KarpelesLab/ledger_nano_s_re/README.md

# Ledger Nano S — Hardware Reverse Engineering

Notes on the hardware of a Ledger Nano S, starting from photos of the bare
PCB. Raw photos are in [`pics/`](pics/). Zoomed crops of the key parts are in
[`docs/img/`](docs/img/).

**Interactive 3D board map: https://karpeleslab.github.io/ledger_nano_s_re/**

> **How sure are we?** Each item below is marked as one of:
> **[confirmed]** (read directly off the board), **[likely]** (strong
> evidence but not checked electrically) or **[hypothesis]** (needs probing).

## Photos

| File | Content |
|---|---|
| `20261112_174544.JPG` | Back side, far half (button S1 / U4 end) |
| `20261112_174549.JPG` | Back side, USB half (5-pad header, U1 thermal vias) |
| `20261112_174600.JPG` | Front, USB half (J1, U1, U2, U3, S2) |
| `20261112_174607.JPG` | Front, far half (J2, U4, L1, S1) |
| `20261112_174622.JPG` | Front, far half (sharper) |
| `20261112_174629/34/41.JPG` | Front, USB half (several focus/lighting variants) |
| `20261112_183829/53.JPG` | Front, USB half, **components removed** (U1, U2, U3, J1, S2 off) |
| `20261112_183835/41.JPG` | Front, far half, **components removed** (J2, U4, L1, C1, C7-C9, S1 off) |
| `20261112_183926.JPG` | Removed U2 and U1, markings upright (ST pin-1 dot at bottom-left) |

The back-side photos are mirrored compared to the front: on the back the USB
connector is on the right.

## Board overview

- 2-layer-looking (maybe more) blue soldermask PCB, long thin strip that fits
  in the swivel case. Notches along the top edge line up with the case clips.
- All parts are on the front (top) side. The back has only traces, vias, test
  pads and the through-hole legs/tabs of J1 and the buttons.
- PCB date code on the back silkscreen: **`1751`** (likely 2017, week 51),
  next to the literal text `YWX` (probably the fab's year/week template
  label). This fits the component date codes (weeks 744 and 749 of 2017).
- An orange paint dot on the USB shield looks like a factory QC/inspection
  mark.
- The PCB edges are rough and fibrous all around. This could be from
  depanelization or from removing the board from its case.

## KiCad reconstruction

There is a KiCad 10 project in [`kicad/`](kicad/). It has the board outline,
every part placed from the photos, the photos as aligned underlay layers, and
a schematic with the nets known so far. Details and assumptions are in
[docs/kicad.md](docs/kicad.md).

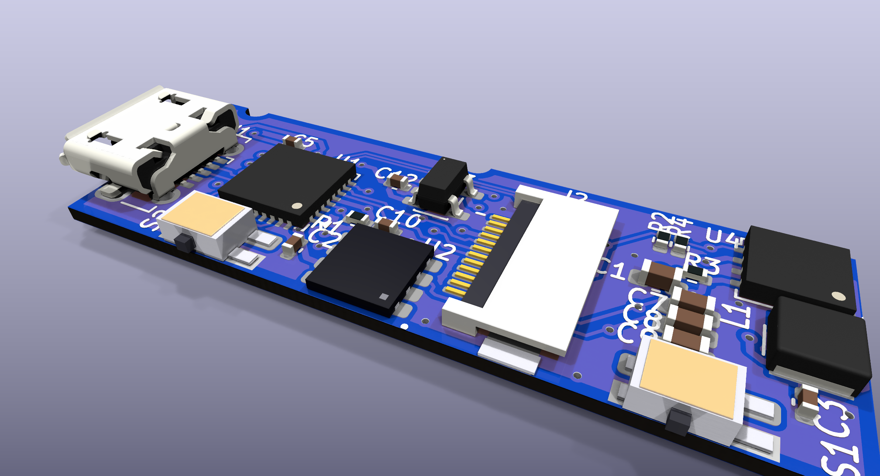
[picture p1: docs/img/render_iso.png]
3D render


**Interactive 3D view:** [online](https://karpeleslab.github.io/ledger_nano_s_re/kicad/viewer3d.html) or [`kicad/viewer3d.html`](kicad/viewer3d.html), published on GitHub Pages by
`.github/workflows/pages.yml` on every push to `master`. To open it locally, serve the `kicad/` folder
over HTTP (e.g. `python3 -m http.server -d kicad`). Hover a part for what it is and the net on
each pin, or a pad, track or via to light up its whole net on both sides. The board photos can be laid
on both faces. Rebuild its data (`kicad/scene.js`, `kicad/photo_*.jpg`) after editing the board with
`python3 tools/export_scene.py`.

## Bill of materials (as seen)

| Ref | Marking | Package | Identification |
|-----|---|---|---|
| **U1** | `F042K6` / `GQ22Z 1193` / `CHN 749 A`, ST logo, e3 | UFQFPN32 (5×5 mm) with exposed pad | **STM32F042K6** Cortex-M0, 32 KB Flash, 6 KB RAM, crystal-less USB FS. This is the main (non-secure) MCU. It handles USB, the display and the buttons. Date code 2017 wk 49. **[confirmed]** |
| **U2** | `NBO` / `PHL744` / `7B`, ST logo | DFN8 + exposed pad, **4.0 x 4.2 mm** (measured). Land pattern: pads 1.2 x 0.75 mm, pitch 0.98 mm, 2.1 x 3.45 mm EP with no vias | ST part, probably the **secure element** (ST31H320 family). ST prints internal codes rather than the part number. It is **not** an MFF2 package (MFF2 is 5x6 mm), so its pinout is ST's own (see below). Date 2017 wk 44. **[likely]** |
| **U3** | `AD30` | SOT-23-5 (3+2 leads), pin 1 dot next to "C12" | **3.0 V LDO**: pins 1 (VIN) and 3 (EN) on VBUS with input cap C12, pin 2 GND, pin 5 (VOUT) on the +3V0 rail (measured **2.997 V**). **[confirmed]** |
| **U4** | `8R00W` / `MYS749`, ST logo, e4 | DFN8 4×4 mm with exposed pad (2×3 thermal vias on the back) | **ST8R00**, a synchronous PWM step-up DC-DC converter. Input 4–6 V, so it must run from USB VBUS rather than the 3.0 V rail. Output is set to 6–12 V by a resistor divider. Switches at 1.7 MHz, up to 1 A. Its external parts are L1, C7–C9 and the R2/R4 divider. The 6–12 V output fits an SSD1306-class OLED panel VCC (7–15 V), so it **almost certainly powers the display**. Date 2017 wk 49. **[likely — marking + datasheet]** |
| **L1** | `100` | ~3×3 mm shielded power inductor | 10 µH. It is the inductor for the ST8R00 boost converter. **[likely]** |
| **J1** | — | Micro-USB B receptacle, SMD with through-hole shield tabs | USB power and data. **[confirmed]** |
| **J2** | pin 1 / pin 12 marked | 12-pin FPC/FFC connector, bottom-contact flip-lock | **OLED display** flex. The Nano S panel is a 128×32 monochrome OLED, usually driven by an SSD1306-class controller. **[likely]** |
| **S1, S2** | — | Side-actuated SMD tactile switches (kapton covered) | The two user buttons. **[confirmed]** |
| C2, C3, C5, C7, C8, C9, C10, C12 | — | 0402 / 0603 / 0805 MLCC | Decoupling and bulk caps. C7–C9 (0805) sit at the regulator. |
| C1 | — | 0603 | The cap just left of the "C7" label, next to the "C1" silkscreen (found while placing parts in KiCad). |
| R1, R2, R3, R4 | — | 0402 | R2/R4 are a pair next to U4. They are probably the ST8R00 feedback divider, which sets the output voltage (6–12 V). |

Crops: [U1](docs/img/u1_stm32f042k6.jpg) · [U2](docs/img/u2_marking.jpg) ·
[U3](docs/img/u3_ad30.jpg) · [U4](docs/img/u4_marking.jpg) ·
[J2](docs/img/j2_fpc.jpg) · [L1/C7–C9](docs/img/l1_c7-c9.jpg)

## U2 secure element pinout

U2 is a DFN8 measuring 4.0 × 4.2 mm, smaller than the MFF2 SIM package (5×6 mm).
The pinout is close to MFF2 but not identical (see below).

**Pin numbering:** the package dot is at the bottom-right in the front photos,
so going counter-clockwise from the top view:

```
            (towards U1/STM32)
              L1  ┌──────┐  R1
   pin 5 ───► ■   │      │   ■ ◄── pin 4
   pin 6 ───► ■   │  U2  │   ■ ◄── pin 3
   pin 7 ───► ■   │      │   ■ ◄── pin 2
   pin 8 ───► ■   │     •│   ■ ◄── pin 1
              L4  └──────┘  R4   (J2 side)
```

**What the board shows** (traces seen visually, not yet checked with a meter):

| Pin | Observation | Likely function |
|-----|---|---|
| 1 | Not connected | NC |
| 2 | Connected to the ground pour | **GND** |
| 3 | STM32 **PA9** (USART1_TX), via the back | **I/O** (confirmed by ATR test) |
| 4 | Not connected | NC |
| 5 | STM32 **PA8** (USART1_CK / MCO) | **CLK** (confirmed by ATR test) |
| 6 | STM32 **PA10** (GPIO) | **RST** (confirmed by ATR test) |
| 7 | +3V0 rail (U3 out, U1.1), decoupled by C2 | **VCC** |
| 8 | Not connected | NC |

Crop: [u2_context.jpg](docs/img/u2_context.jpg)

**Relation to MFF2:** the pinout is MFF2-like, with the unused pair moved to
the other end of the package. Pins are listed as MFF2 (ETSI TS 102 671, from
memory) → U2:

| Pin | MFF2 | U2 |
|-----|---|----|
| 1 | C5 GND | NC |
| 2 | C6 SWP | GND |
| 3 | C7 I/O | I/O |
| 4 | C8 NC | NC |
| 5 | C4 NC | CLK |
| 6 | C3 CLK | RST |
| 7 | C2 RST | VCC |
| 8 | C1 VCC | NC |

Pins 5–8 are the MFF2 sequence (unused, CLK, RST, VCC) with the unused pin
moved to the end. Pins 1–4 have I/O and the unused SWP slot swapped compared
to a straight shift. That puts **pin 6 = RST**, so PA10 is the SE reset.

Pins 3, 5 and 6 go to PA9 (USART1_TX), PA8 (USART1_CK) and PA10 (GPIO). That
is the STM32 USART1 **smartcard-mode** wiring: TX as the half-duplex I/O line,
CK as the card clock, and a GPIO as RST. So the MCU ↔ SE link is ISO 7816-3
over USART1. See [docs/tracing.md](docs/tracing.md).

### ATR test (chip removed from the board)

The removed U2 was wired to a Baochip-1x (dabao): 3.3 V to pin 7, GND to pin
2, PB1 to pin 6 (RST), PB2 to pin 5 (CLK) and PB3 to pin 3 (I/O, 10 kΩ
pull-up to 3.3 V). Bit-banged ISO 7816-3 cold reset at a CLK of about 1.95 MHz,
using the `sc atr` command of the `iso7816-probe` branch of xous-core
(`baremetal/src/iso7816.rs`):

```
ATR: 3B 90 98 10 00      first start bit 823 clocks after RST, 0 parity errors
TS=3B direct convention
T0=90 TA1, TD1 present, no historical bytes
TA1=98 Fi=512, Di=12  ->  1 etu = 42.67 clocks
TD1=10 T=0, TA2 present
TA2=00 specific mode: T=0 at Fi/Di from TA1 (no PPS)
```

This confirms the pinout (3 = I/O, 5 = CLK, 6 = RST). The MCU ↔ SE link is
ISO 7816 **T=0**. Di index 8 is 12 in ISO's table, but Ledger uses it as 128:
the live capture below shows 4 clocks per bit, not 42.67.

### Live capture (MCU ↔ SE on a working device)

A logic analyzer capture of CLK, I/O and RST on a working Nano S is decoded in
[docs/seproxyhal_capture.md](docs/seproxyhal_capture.md); the protocol itself
(framing, every tag, and which ones each firmware version uses) is documented in
[docs/seproxyhal_protocol.md](docs/seproxyhal_protocol.md). In short:

- The MCU clocks the SE at **11.96 MHz**. The ATR comes at the default 372
  clocks per bit, then a PPS (`FF 10 98 77`) switches the link to **4 clocks
  per bit, about 3 Mbaud** (an earlier version of this README gave 45.6 kbaud
  from the ISO table).
- On top runs **SEPROXYHAL 1.6**: the SE draws the screen as BAGL elements,
  the MCU forwards buttons, ticks and USB events, and the SE answers USB
  enumeration itself. USB only comes up after the PIN is entered.
- At every boot the SE first **reads the MCU's whole 32 KB flash** over the
  link; the flash ends with a secp256k1 ECDSA signature over SHA-256 of the
  image. The captured **MCU 1.0 image is byte-for-byte Ledger's public
  `nanosr1` release**, signed under Ledger's documented root-of-trust key; MCU
  1.6 and 1.12 are signed with other (unknown) Ledger keys.
  `tools/mcu_flash_from_seph.py` rebuilds the image from a capture; the
  reconstructed images (needed for interoperability with the SE) are in
  [`mcu_firmware/`](mcu_firmware/).

## Back side / test access

- **5-pad row** with silkscreen rings near the top edge (USB half), with a
  dot marking one end. These are round solder-bumped pads, not plated
  through-holes. They form the STM32 **SWD port**: TP1 +3V0, TP2 SWCLK,
  TP3 GND, TP4 SWDIO, TP5 NRST. **[likely, traced]** Crop:
  [back_5pad_header.jpg](docs/img/back_5pad_header.jpg)
- 9 more **solder-bumped test pads** sit on the **OLED connector nets**:
  SPI SCK/MOSI, the PA0/PA1/PA2 control lines, and the J2.1/J2.10–12 power
  pins. They are bed-of-nails test points for the display interface.
  **[likely, traced]**
- **3×3 thermal via grid** = U1 exposed pad. **2×3 via grid** at the far end =
  U4 exposed pad.
- Large oval pads next to the USB end = J1 shield tabs.

## Architecture (traced; matches public Ledger documentation)

```
 USB ──J1── PA11/PA12 ─► STM32F042K6 (U1, "MCU")
                          │ USART1 smartcard: PA9=I/O, PA8=CLK 12 MHz, PA10=RST ─► ST31 SE (U2), 3 Mbaud
                          │ SPI1: PA5=SCK, PA7=MOSI + PA0/PA1/PA2 ─► J2 ─► 128×32 OLED
                          │ PA15 ◄─ S2      PB7 ◄─ S1
                          └ SWD: back header TP1..5 = 3V0, SWCLK, GND, SWDIO, NRST
 Power: VBUS (5 V) ─► U3 LDO (AD30) ─► +3V0 (MCU, SE, OLED VDD, U4 EN)
        VBUS (5 V) ─► L1 ─► U4 ST8R00 boost (R3/R4 FB) ─► J2.1 OLED panel VCC
```

In the Nano S design the MCU acts as a proxy. It owns USB, the screen and the
buttons. The secure element runs BOLOS and the apps, and it drives the UI
through the MCU (the "SEPROXYHAL" protocol).

## Next steps / TODO

The board is fully traced (both sides), every part and net is mapped, the U2
pinout and the MCU↔SE link are characterised, and the MCU firmware is captured
(see the sections above and [docs/](docs/)). What is still open:

- [ ] Probe the 5-pad header: continuity to U1 pins PA13 (SWDIO), PA14
      (SWCLK) and NRST. Try `st-link`/OpenOCD (it will probably be RDP-locked).
- [ ] Talk T=0 to the SE directly, at 4 clocks per bit after the PPS.
- [ ] Confirm the OLED supply: read R2/R4 (or measure the boost output), check
      it reaches J2, and whether the MCU drives the ST8R00 EN pin to switch the
      display power.
- [ ] Match the J2 pinout against the known SSD1306 FPC pinouts.
