KarpelesLab/ledger_nano_s_re/docs/img/back_5pad_header.jpg

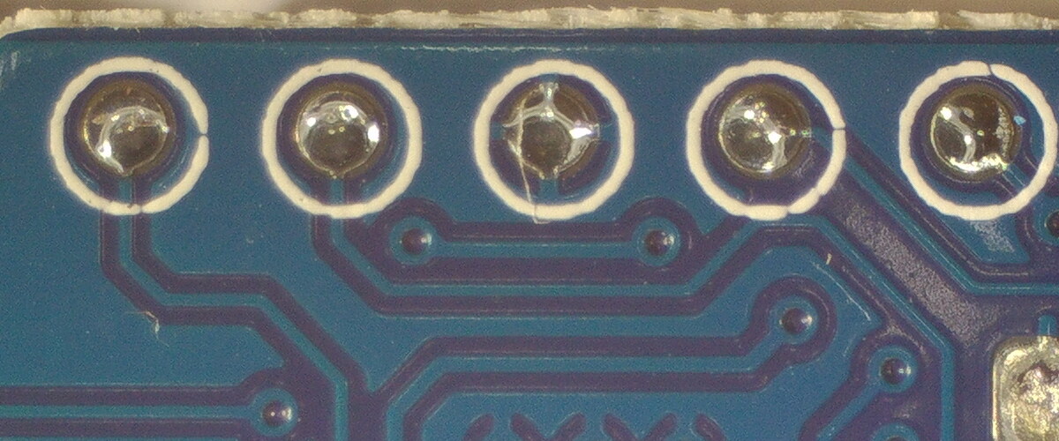
docs/img/back_5pad_header.jpg
