KarpelesLab/ledger_nano_s_re/docs/img/j2_fpc.jpg

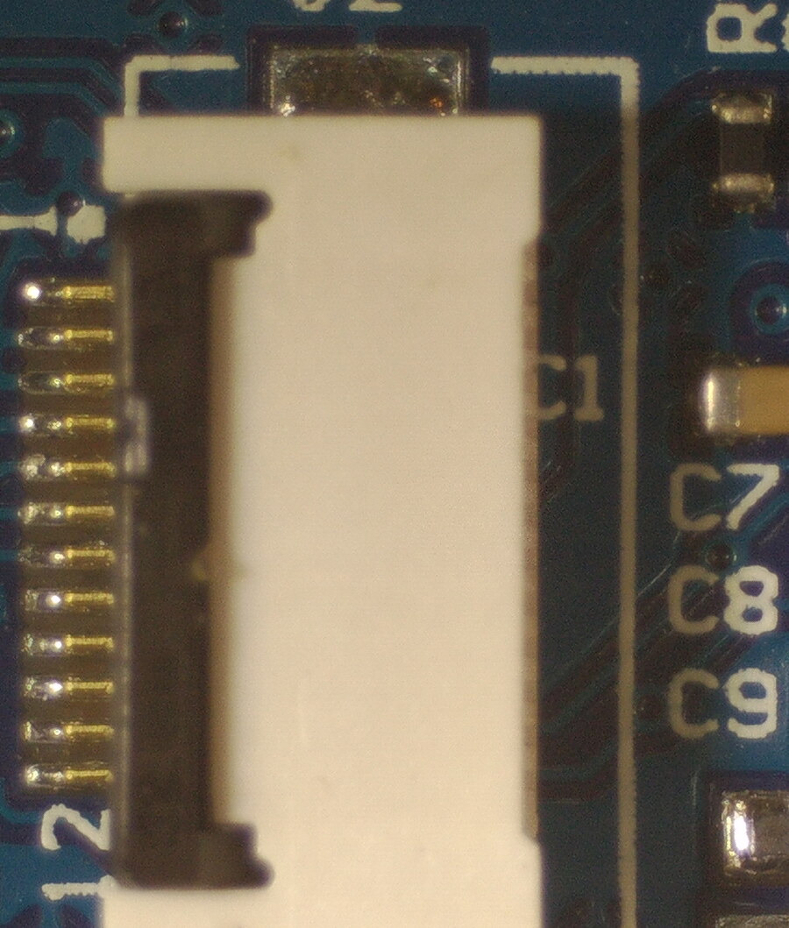
docs/img/j2_fpc.jpg
