KarpelesLab/ledger_nano_s_re/docs/img/l1_c7-c9.jpg

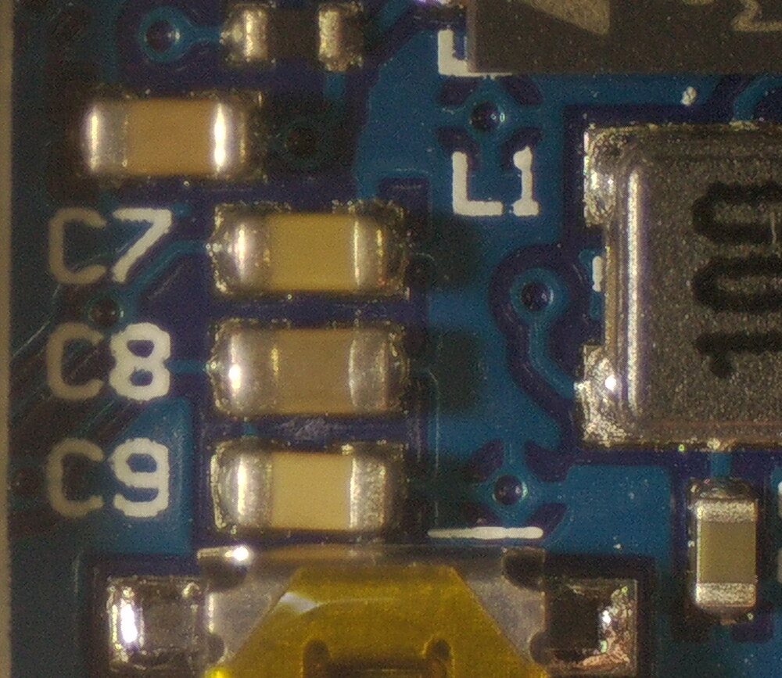
docs/img/l1_c7-c9.jpg
