KarpelesLab/ledger_nano_s_re/docs/img/stitched_back.jpg

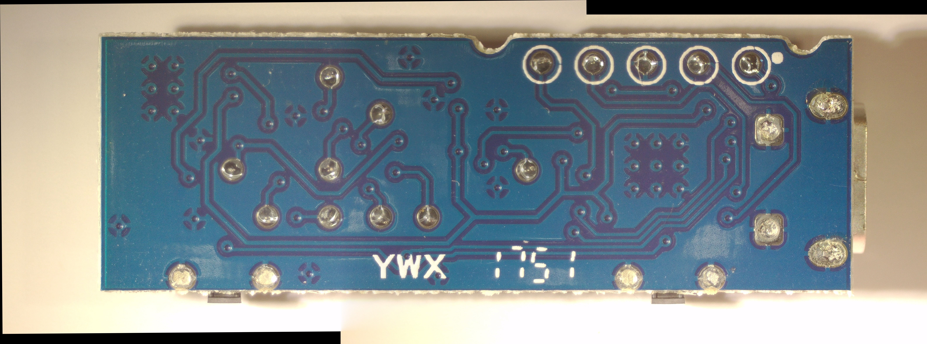
docs/img/stitched_back.jpg
