KarpelesLab/ledger_nano_s_re/docs/img/stitched_front.jpg

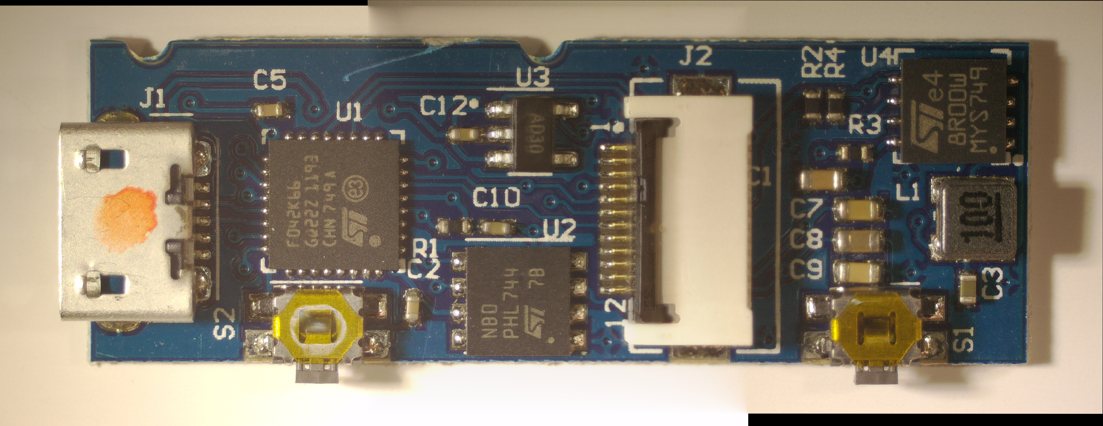
docs/img/stitched_front.jpg
