KarpelesLab/ledger_nano_s_re/docs/img/stitched_front_bare.jpg

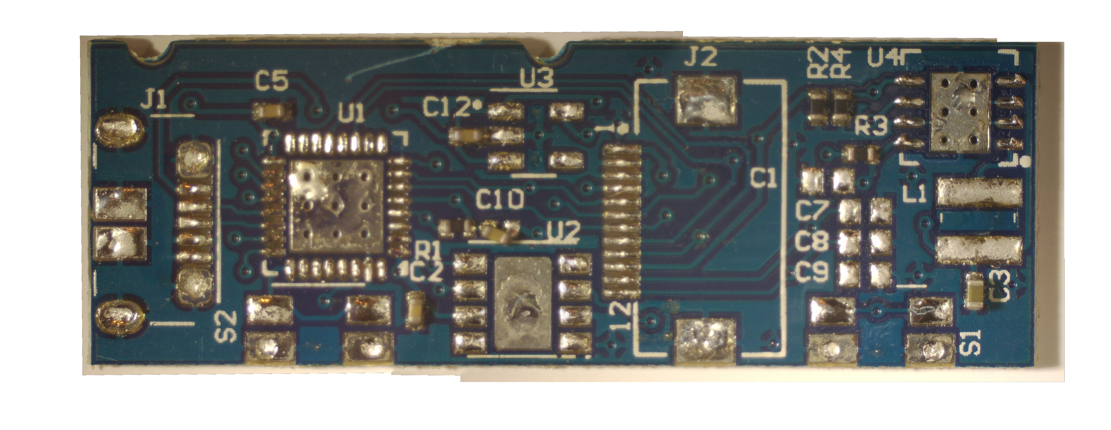
docs/img/stitched_front_bare.jpg
