KarpelesLab/ledger_nano_s_re/docs/img/trace_back_islands.jpg

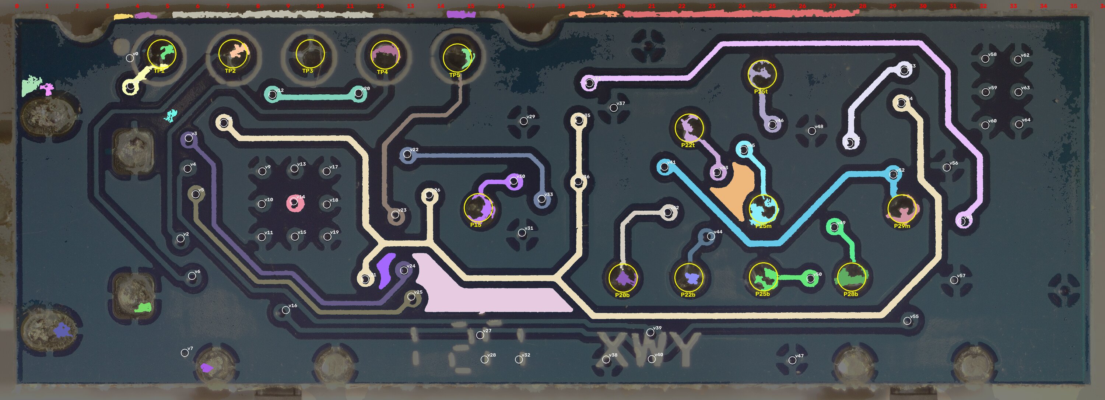
docs/img/trace_back_islands.jpg
