KarpelesLab/ledger_nano_s_re/docs/img/trace_back_xcf.jpg

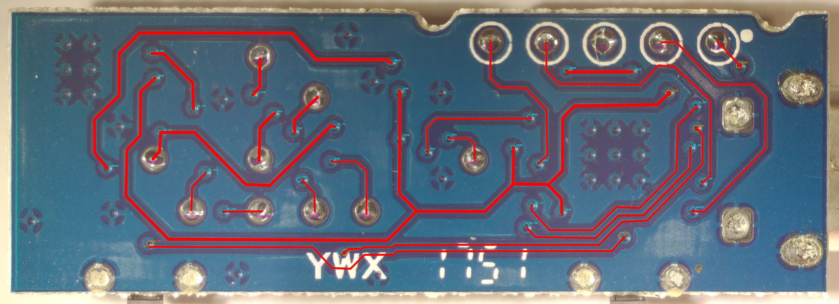
docs/img/trace_back_xcf.jpg
