KarpelesLab/ledger_nano_s_re/docs/img/trace_back_xcf_layer.png

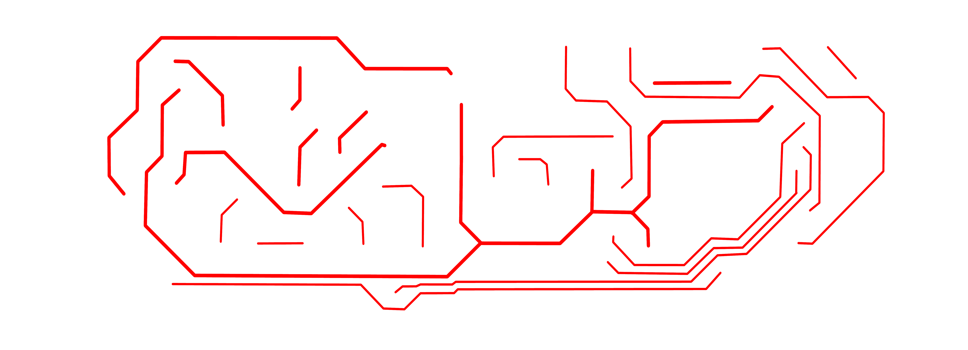
docs/img/trace_back_xcf_layer.png
