KarpelesLab/ledger_nano_s_re/docs/img/trace_front_u2_u3.jpg

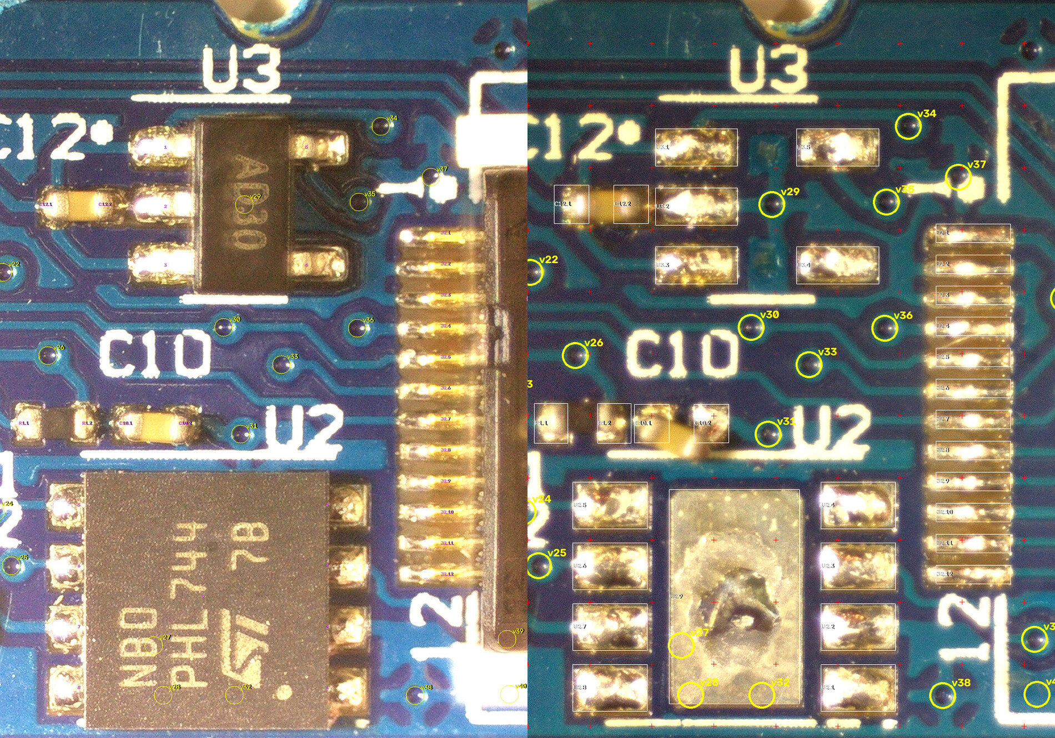
docs/img/trace_front_u2_u3.jpg
