KarpelesLab/ledger_nano_s_re/docs/img/trace_front_xcf_layer.png

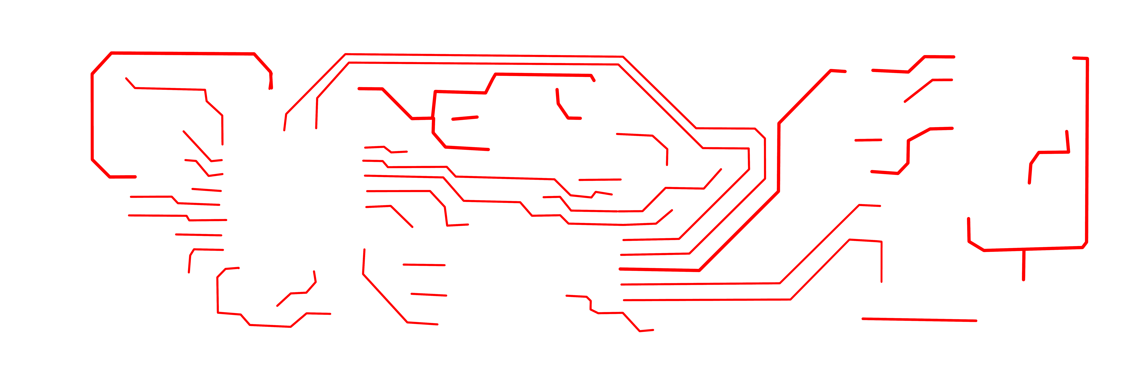
docs/img/trace_front_xcf_layer.png
