KarpelesLab/ledger_nano_s_re/docs/img/u1_stm32f042k6.jpg

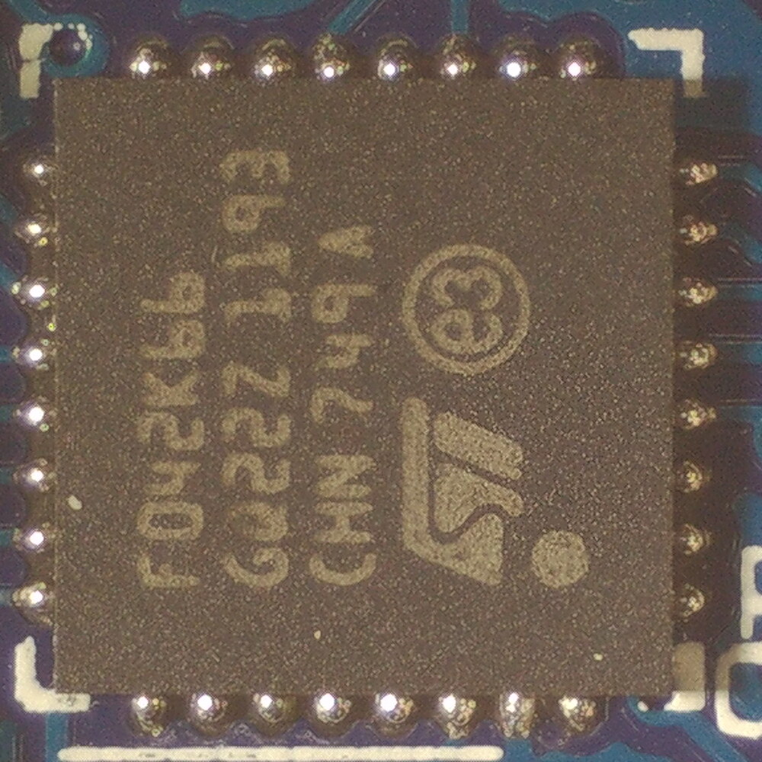
docs/img/u1_stm32f042k6.jpg
