KarpelesLab/ledger_nano_s_re/docs/img/u2_context.jpg

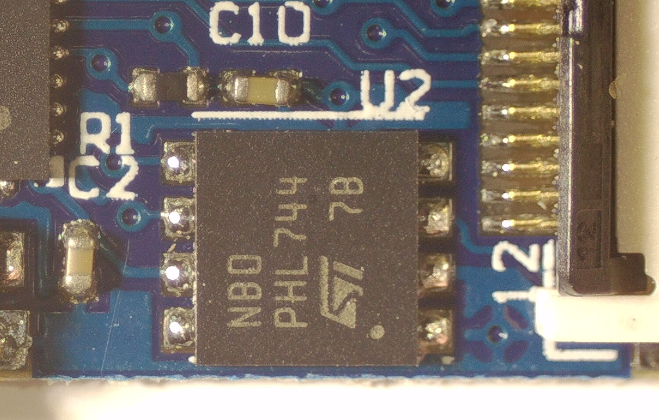
docs/img/u2_context.jpg
