KarpelesLab/ledger_nano_s_re/docs/img/u2_marking.jpg

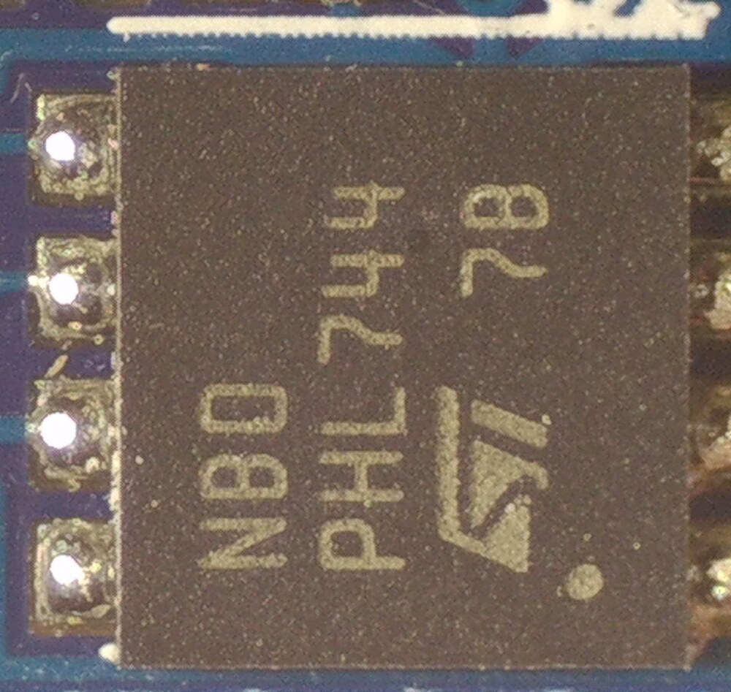
docs/img/u2_marking.jpg
