KarpelesLab/ledger_nano_s_re/docs/img/u3_ad30.jpg

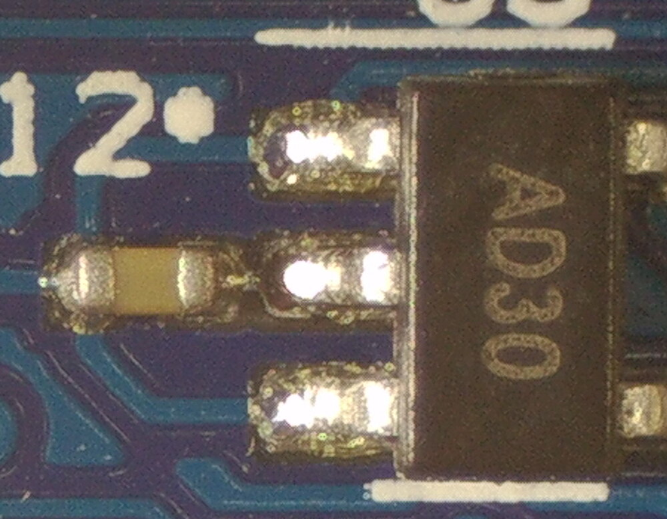
docs/img/u3_ad30.jpg
