KarpelesLab/ledger_nano_s_re/docs/img/u4_marking.jpg

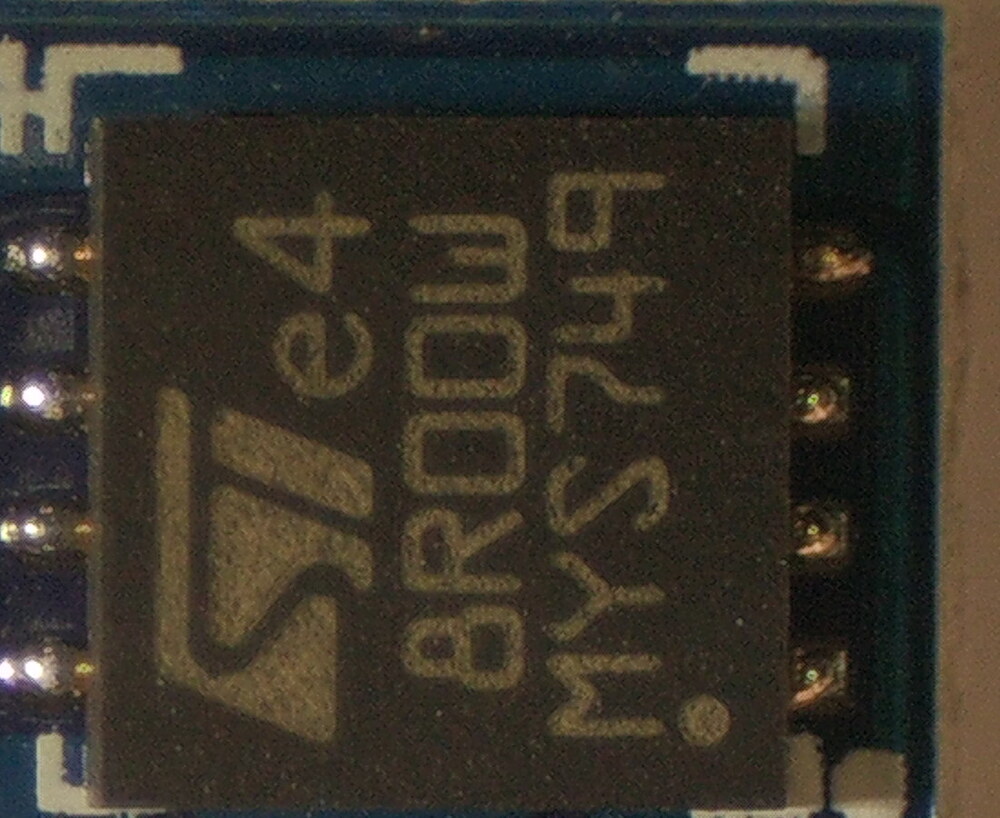
docs/img/u4_marking.jpg
