KarpelesLab/ledger_nano_s_re/kicad/photo_back.jpg

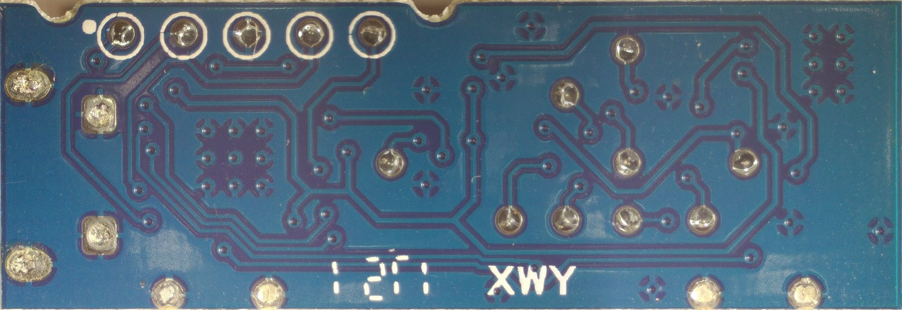
kicad/photo_back.jpg
