KarpelesLab/ledger_nano_s_re/kicad/photo_front.jpg

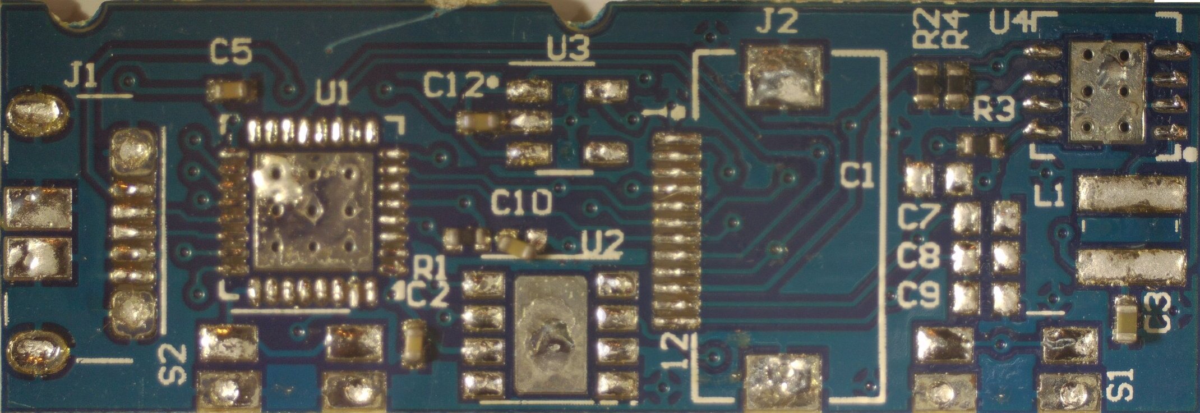
kicad/photo_front.jpg
