KarpelesLab/ledger_nano_s_re/pics/20261112_174622.JPG

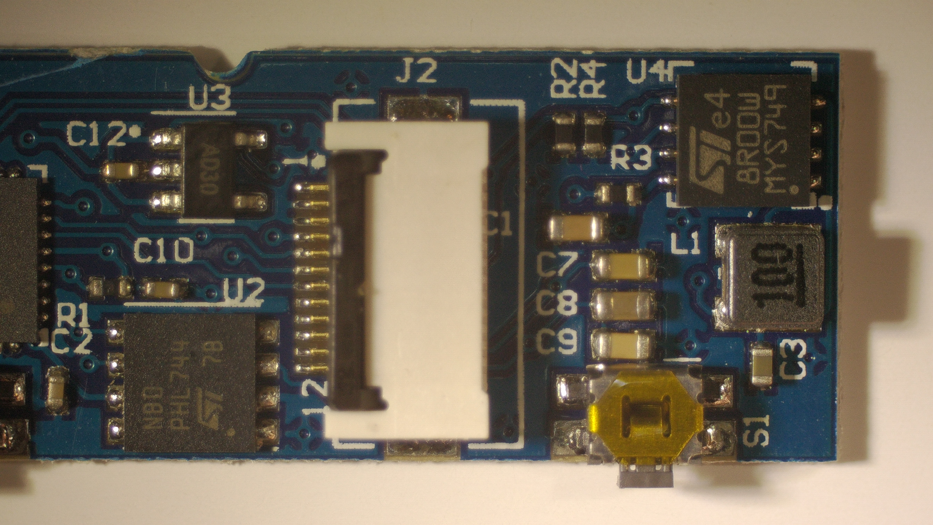
pics/20261112_174622.JPG
