KarpelesLab/ledger_nano_s_re/pics/20261112_174629.JPG

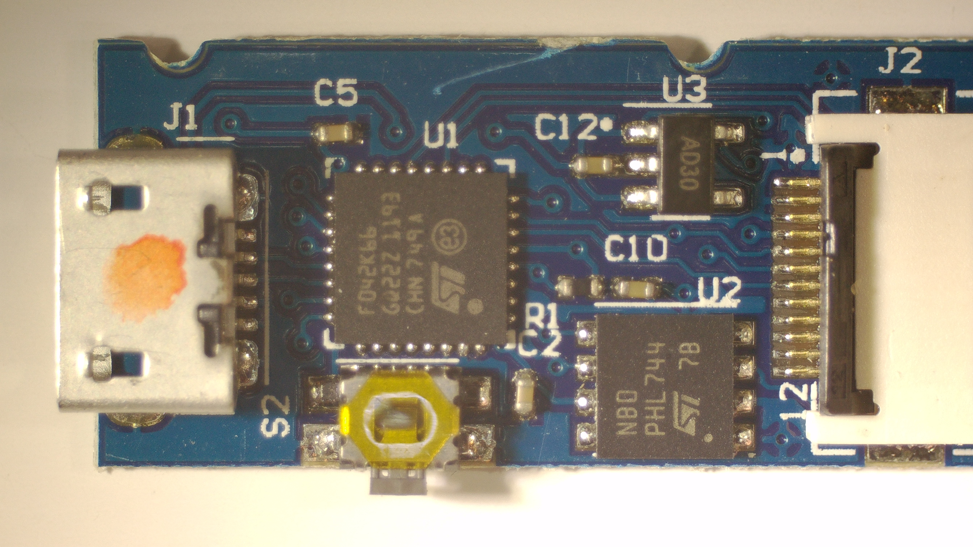
pics/20261112_174629.JPG
