KarpelesLab/ledger_nano_s_re/pics/20261112_183835.JPG

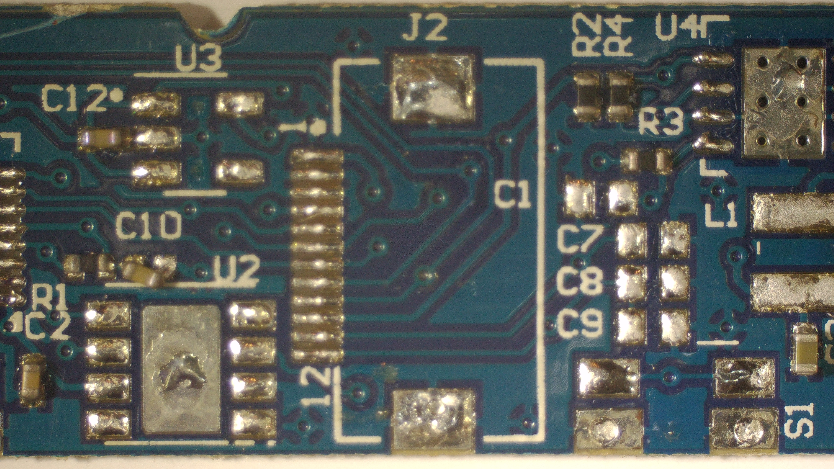
pics/20261112_183835.JPG
