KarpelesLab/ledger_nano_s_re/pics/20261112_183841.JPG

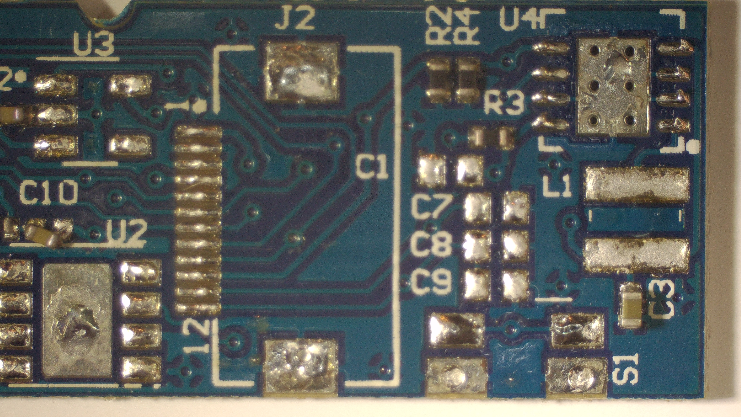
pics/20261112_183841.JPG
