KarpelesLab/ledger_nano_s_re/kicad/ledger_nano_s.kicad_pcb

## KiCad design kicad/ledger_nano_s.kicad_pcb (2026-11-12)

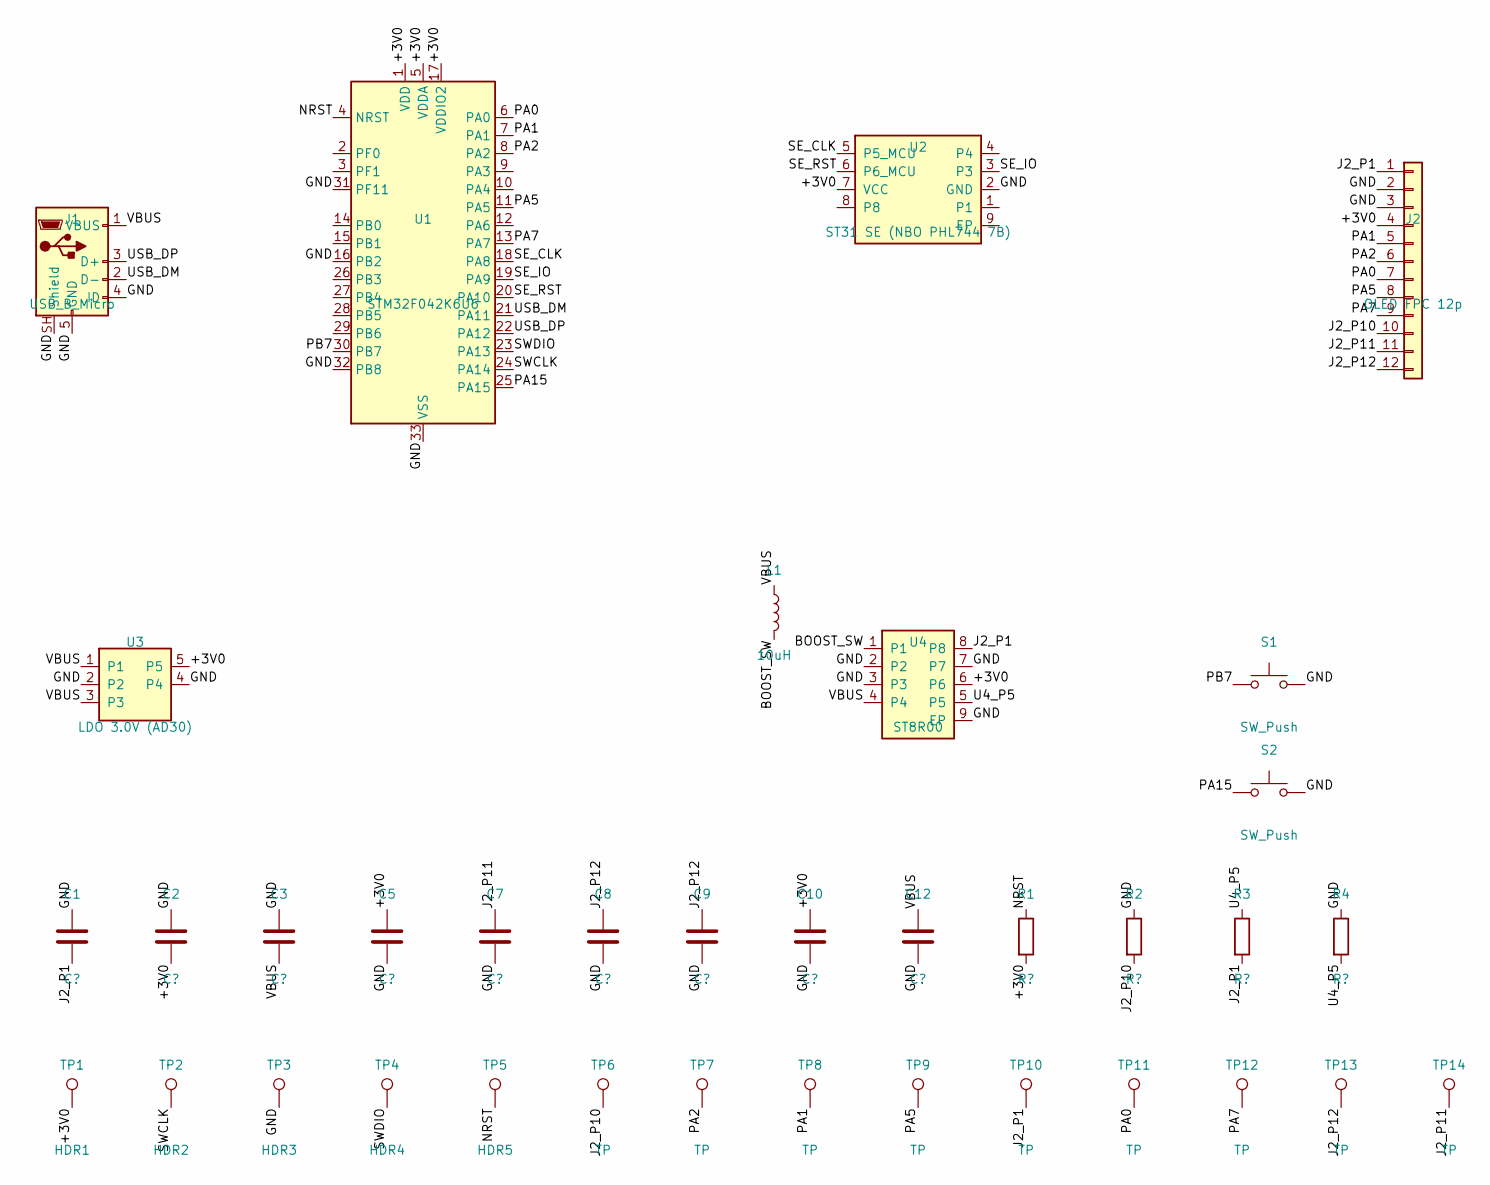
[picture p41: schematic ledger_nano_s.kicad_sch, Ledger Nano S - reconstruction]

Parts:
C1, C7, C8, C9: C?; C_0603_1608Metric
C2, C3, C5, C10, C12: C?; C_0402_1005Metric
J1: USB_B_Micro; USB_Micro-B_Molex-105017-0001
J2: OLED FPC 12p; FPC_12P_P0.5mm_Pin1Top
L1: 10uH; L_Abracon_ASPI-3012S
R1, R2, R3, R4: R?; R_0402_1005Metric
S1, S2: SW_Push; SW_SideTact_P3.8x1.38mm
TP1: HDR1; TestPoint_Pad_D1.5mm
TP2: HDR2; TestPoint_Pad_D1.5mm
TP3: HDR3; TestPoint_Pad_D1.5mm
TP4: HDR4; TestPoint_Pad_D1.5mm
TP5: HDR5; TestPoint_Pad_D1.5mm
TP6, TP7, TP8, TP9, TP10, TP11, TP12, TP13, TP14: TP; TestPoint_Pad_D1.0mm
U1: STM32F042K6U6; UFQFPN-32-1EP_5x5mm_P0.5mm_EP3.5x3.5mm
U2: ST31 SE (NBO PHL744 7B); ST_DFN8-1EP_4.0x4.2mm_P0.98mm
U3: LDO 3.0V (AD30); SOT-23-5
U4: ST8R00; DFN-8-1EP_4x4mm_P0.8mm_EP2.3x3.24mm

Connections:
+3V0: C2.2, C5.1, C10.1, J2.4, R1.2, TP1.1, U1.1 (VDD), U1.5 (VDDA), U1.17 (VDDIO2), U2.7 (VCC), U3.5, U4.6
BOOST_SW: L1.2, U4.1
GND: C1.1, C2.1, C3.1, C5.2, C7.2, C8.2, C9.2, C10.2, C12.2, J1.4 (ID), J1.5 (GND), J1.SH (Shield), J2.2, J2.3, J2.MP, R2.1, R4.1, S1.2, S2.2, TP3.1, U1.16 (PB2), U1.31 (PF11), U1.32 (PB8), U1.33 (VSS), U2.2 (GND), U3.2, U3.4, U4.2, U4.3, U4.7, U4.9 (EP)
J2_P1: C1.2, J2.1, R3.2, TP10.1, U4.8
J2_P10: J2.10, R2.2, TP6.1
J2_P11: C7.1, J2.11, TP14.1
J2_P12: C8.1, C9.1, J2.12, TP13.1
NRST: R1.1, TP5.1, U1.4 (NRST)
PA0: J2.7, TP11.1, U1.6 (PA0)
PA1: J2.5, TP8.1, U1.7 (PA1)
PA2: J2.6, TP7.1, U1.8 (PA2)
PA5: J2.8, TP9.1, U1.11 (PA5)
PA7: J2.9, TP12.1, U1.13 (PA7)
PA15: S2.1, U1.25 (PA15)
PB7: S1.1, U1.30 (PB7)
SE_CLK: U1.18 (PA8), U2.5 (P5_MCU)
SE_IO: U1.19 (PA9), U2.3
SE_RST: U1.20 (PA10), U2.6 (P6_MCU)
SWCLK: TP2.1, U1.24 (PA14)
SWDIO: TP4.1, U1.23 (PA13)
U4_P5: R3.1, R4.2, U4.5
USB_DM: J1.2 (D-), U1.21 (PA11)
USB_DP: J1.3 (D+), U1.22 (PA12)
VBUS: C3.2, C12.1, J1.1 (VBUS), L1.1, U3.1, U3.3, U4.4

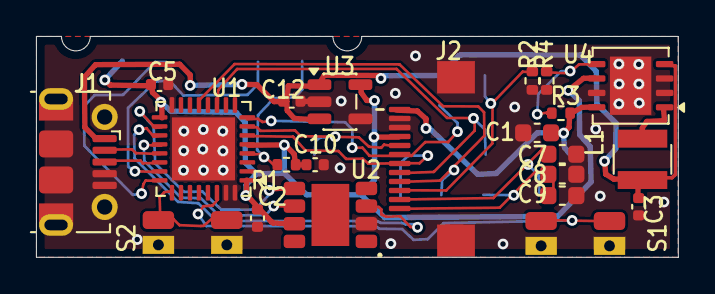
[picture p42: board ledger_nano_s.kicad_pcb from above]

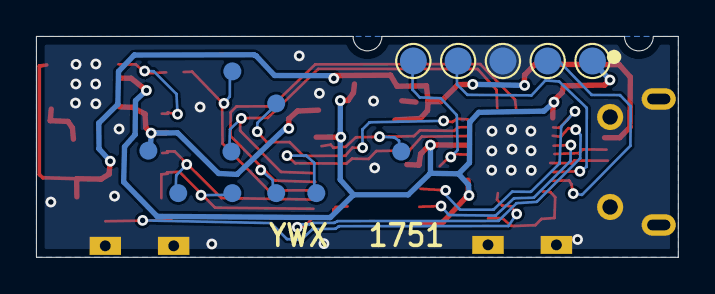
[picture p43: board ledger_nano_s.kicad_pcb from below]

Board: 2 copper layers, 35.7 x 12.3 mm, 36 parts (14 on the bottom side), 24 nets.
