KarpelesLab/ledger_nano_s_re/(commit log)

2026-11-12 Initial board documentation from photos
    Add PCB photos, zoomed component crops, and README with BOM,
    identifications (STM32F042K6 MCU, likely ST31 SE, LDO, boost),
    test-pad observations and next RE steps.
2026-11-12 Add ST8R00 datasheet details: VBUS-fed 6-12V boost for OLED VCC
2026-11-12 U2: record observed non-standard MFF2 pinout (GND=2, VCC=7, 5/6 to MCU)
2026-11-12 U2: measured 4.0x4.2mm DFN8, not MFF2
2026-11-12 Add KiCad reconstruction: outline, placement, photo underlays, partial schematic
    Generated by tools/gen_kicad.py from stitched, measured board photos.
    [ledger_nano_s.kicad_pcb, ledger_nano_s.kicad_sch]
2026-11-12 Add bare-board photos; refine footprints from exposed land patterns
    - U2: real land pattern incl. 2.1x3.45mm exposed pad (pitch 0.98, cols 4.0mm)
    - J2 tabs at +-4.54mm, switches 4x 1.75x1.0 pads at +-1.9mm, L1 rotated 90
    - New stitched bare-front photo as KiCad layer User.3 for copper tracing
    [ledger_nano_s.kicad_pcb, ledger_nano_s.kicad_sch]
2026-11-12 Docs: bare-board photos, U2 exposed pad, refined footprints
2026-11-12 Trace copper from photos: SWD header pinout, USB, power and SE nets + 60 vias
    [ledger_nano_s.kicad_pcb, ledger_nano_s.kicad_sch]
2026-11-12 Apply hand-traced front copper (XCF overlay): J2 OLED pinout, boost, LDO, SE and button nets
    Registered both photo layers of pics/20261112_183853.xcf to the board,
    mapped the red trace strokes to KiCad pads/vias and merged the
    placeholder test-pad nets into named nets. Fixes U3 pinout (pin 5 is
    VOUT; VBUS reaches the boost via 19.14,2.33) and clears the C1/via DRC
    short (same net).
    [ledger_nano_s.kicad_pcb, ledger_nano_s.kicad_sch]
2026-11-12 Add 2 missed thermal-relief GND vias (62 total)
    [ledger_nano_s.kicad_pcb, ledger_nano_s.kicad_sch]
2026-11-12 Apply hand-traced back copper: PA9->SE I/O, PB7->S1, fix SWD header (TP1=3V0, TP3=GND)
    [ledger_nano_s.kicad_pcb, ledger_nano_s.kicad_sch]
2026-11-12 3D: 0.8 mm stackup, custom U2/J2/S1/S2 models, real silkscreen layout, render script + renders
    [ledger_nano_s.kicad_pcb, ledger_nano_s.kicad_sch]
2026-11-12 Add copper: tracks from the hand-traced front/back layers + GND pours
    [ledger_nano_s.kicad_pcb, ledger_nano_s.kicad_sch]
2026-11-12 Untraced pads -> GND, tighter pour (clean connectivity)
    [ledger_nano_s.kicad_pcb, ledger_nano_s.kicad_sch]
2026-11-12 U2: only pin 2 is GND; pins 1/4/8 and EP not connected
    [ledger_nano_s.kicad_pcb, ledger_nano_s.kicad_sch]
2026-11-12 U2: document MFF2-like pinout (unused pair moved), pin 6 = RST
2026-11-12 SE ATR captured (3B 90 98 10 00): confirms U2 3=I/O 5=CLK 6=RST; rename nets SE_CLK/SE_RST
    [ledger_nano_s.kicad_pcb, ledger_nano_s.kicad_sch]
2026-11-12 Cynthion: Nano S SEPROXYHAL MCU-emulator gateware (Amaranth) + pysim (PASS)
    Ports the Nano X mcuemu_core to the Nano S ST31 3-wire ISO 7816 T=0 link: generates
    CLK+RST, 8E parity UART at etu=372 CLK cycles, RX gated on ~io_oe (no self-loopback),
    frame parser enabled only after SESSION_START (ATR is not a SEPROXYHAL frame). FSM per
    nanos-nonsecure-firmware: SESSION_START -> reply DISPLAY_PROCESSED to SCREEN_DISPLAY,
    send TICKER after GENERAL_STATUS. sim_nanos.py validates all of this against a fake SE.
2026-11-12 Cynthion: r1.4 top-level (PMOD A 1/2/3 = RST/CLK/IO) + LEDs, builds to bitstream
2026-11-12 Cynthion: stream received SE bytes out the Apollo UART (ttyACM1) via a FIFO+UART TX
2026-11-12 Cynthion: gate UART off by default (T14=JTAG TMS); default build is JTAG-safe (LEDs only)
2026-11-12 Cynthion USB readback on AUX: enumerates as /dev/ttyACM (1209:0001), CDC path proven
    reticle usb_cdc_acm_ulpi on the aux ULPI PHY, built with yosys/amaranth. Fixes that got it
    enumerating: PULLMODE=NONE on ULPI pins, VENDOR_DATA=0x06 (USB3343 SwapDP/DM), POR reset,
    serial_state=0b11. Host read needs DTR raised. CDC verified end to end with a TEST byte-counter
    (67 KB delivered) and a 0x55 heartbeat. OPEN: in the combined build the emulator receives SE
    bytes (rx_seen=1) but doesn't finish ATR->SESSION_START boot (booted=0); standalone LED build
    booted fine. atr_idle bumped 60k->300k (1ms was < the ~2ms inter-byte at etu=372).
2026-11-14 Interactive 3D board viewer with hover details for every part, pad and net
    tools/export_scene.py exports the KiCad board to kicad/scene.js: outline, copper,
    pours, silkscreen, each part's real 3D model (via kicad-cli PLY export), pin names,
    part descriptions and net purposes, plus the board photos cropped for both faces.
    kicad/viewer3d.html renders it with three.js, as in the Nano X project.
2026-11-14 Publish the 3D viewer on GitHub Pages, with a landing page and README links
2026-11-14 Decode the SEPROXYHAL capture: 3 Mbaud link, SE reads the MCU flash at boot
    The ATR is at 372 clocks per bit, then PPS1 0x98 gives 4 clocks per bit
    (Ledger reads Di index 8 as 128): the README's 45.6 kbaud was wrong. The SE
    reads all 32 KB of MCU flash at boot; the flash ends with an ECDSA signature
    over the first 0x7fb8 bytes. tools/mcu_flash_from_seph.py rebuilds the image
    from a visgrok log (the image itself is not committed).
    [mcu_flash_from_seph.py]
2026-11-14 SEPROXYHAL notes: compare the MCU image with nanos-nonsecure-firmware
    Same layout and build (random fill, secp256k1 signature + FF), but the
    device runs version 1.6 with UNSEC_CHUNK_READ_EXT; the published source
    stops at 1.1.
2026-11-14 MCU 1.0 image == public nanosr1 release, signed under Ledger root of trust
    Device 2 (MCU 1.0) matches LedgerHQ/nanos-nonsecure-firmware-releases nanosr1
    byte-for-byte including the signature (only 6 trailing non-signed fill bytes
    differ). Recovering keys from the v1.0 and v1.1 releases (grafting device 2's
    bootloader under the v1.1 app) yields one shared key, 0490f5c9...dad609, which
    is documented online as the Ledger root-of-trust public key and verifies the
    device 2 signature. This confirms the curve (secp256k1) and the signed message
    (SHA-256 of the full flash to the signed length). MCU 1.6 and 1.12 do not verify
    under it and differ from each other: other Ledger keys, still unknown.
    Co-A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
2026-11-14 Note jasonbhwong/Ledger MCU 1.6 images; a different 1.6 build than device 1
    The mcu_1.6_over_0.8.hex there is genuine MCU 1.6 (for bootloader 0.8) but a
    different build from the device-1 capture (14288/20224 app bytes differ, different
    signature). Its signing key can't be recovered without the exact bootloader-0.8
    bytes (the signed message covers the bootloader, as confirmed with the releases),
    and blup_0.8 embeds the bootloader inside an updater app, not as a clean image.
2026-11-14 Add reconstructed MCU firmware images (interoperability with the SE)
    The non-secure STM32 MCU firmware (full 32 KB flash) for MCU 1.0, 1.6 and 1.12,
    reconstructed from the SEPROXYHAL flash-read captures. These are what the SE reads
    and verifies at boot, so they are needed by anything standing in for the MCU; they
    hold no device secrets. mcu_nanos_1.0.bin is byte-for-byte Ledger's public nanosr1
    release. Ledger's firmware, (c) Ledger, Apache-2.0; some are also published by
    Ledger as hex. mcu_firmware/README.md has versions, hashes, keys and provenance.
2026-11-14 +3V0 rail (U3 output) measured at 2.997 V: U3 confirmed as the 3.0 V LDO
2026-11-14 README TODO: back copper is fully traced (board-aligned back image), mark done
2026-11-14 Prune the TODO list to the genuinely open items
    Drop the completed entries (recorded in the BOM, docs/tracing.md and the
    SEPROXYHAL docs); keep the four tasks still open.
